sajidhasanapon/4-bit-SAP-Computer/Block_Diagram/README.txt

The block diagram has been drawn using draw.io

The diagram can be edited using the .xml file.

1. Go to https://www.draw.io/
2. Select "Open Existing Diagram"
3. Browse and upload the .xml file
