sajidhasanapon/4-bit-SAP-Computer/Report/Final_Report/DOCX/Cover.docx

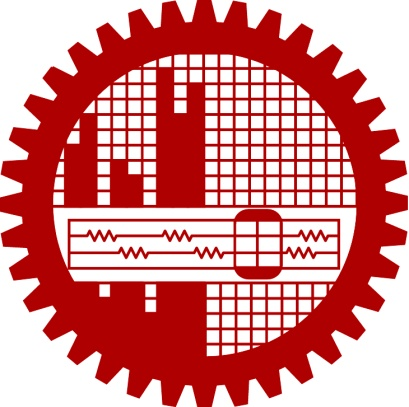
[picture p2: figure]

BANGLADESH UNIVERSITY OF ENGINEERING & TECHNOLOGY

CSE 404

DIGITAL SYSTEM DESIGN SESSIONAL

4-BIT SIMPLE AS POSSIBLE (SAP) COMPUTER

Submitted By: 1305006 1305020 1305026 1305056 1305058 | Section: B1 Group: 03
