sajidhasanapon/4-bit-SAP-Computer/Report/Timing_Diagrams/timing_out.xlsx

 |  | T5
CLK | `
EA_BAR
LO_BAR
RESET
