sajidhasanapon/4-bit-SAP-Computer/Report/Timing_Diagrams/timing_ret.xlsx

 |  | T5 | T6 | T7 | T8
CLK | `
LM_BAR
EM_BAR
R_BAR
EDB_BAR
ES_BAR
LDR_BAR
LP
CP
IS
RESET
