sajidhasanapon/4-bit-SAP-Computer/Report/Schematics/mar.pdf

# M7 GND

U66:A

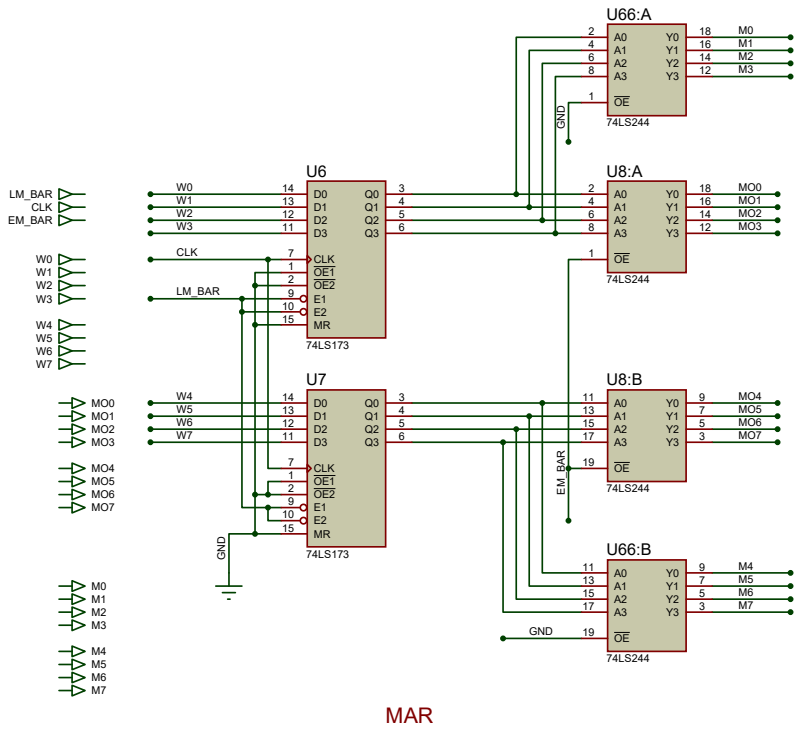
[picture p3: page 1]
