sajidhasanapon/4-bit-SAP-Computer/Report/Schematics/pc.pdf

U45:A

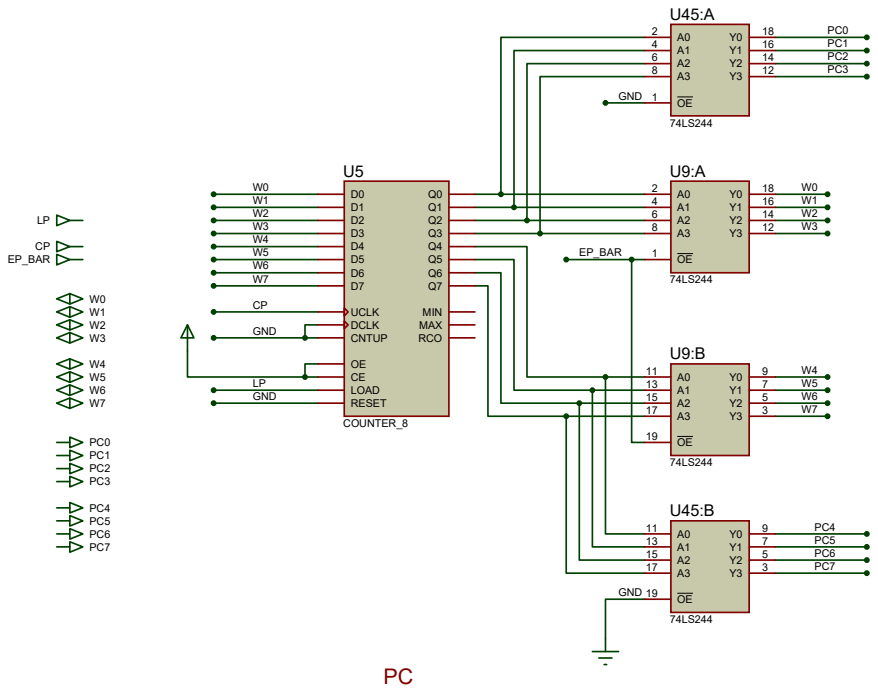
[picture p4: page 1]

GND | 1

A1 13
A2 15
A3 17
