sajidhasanapon/4-bit-SAP-Computer/Report/Schematics/sp.pdf

U25:A

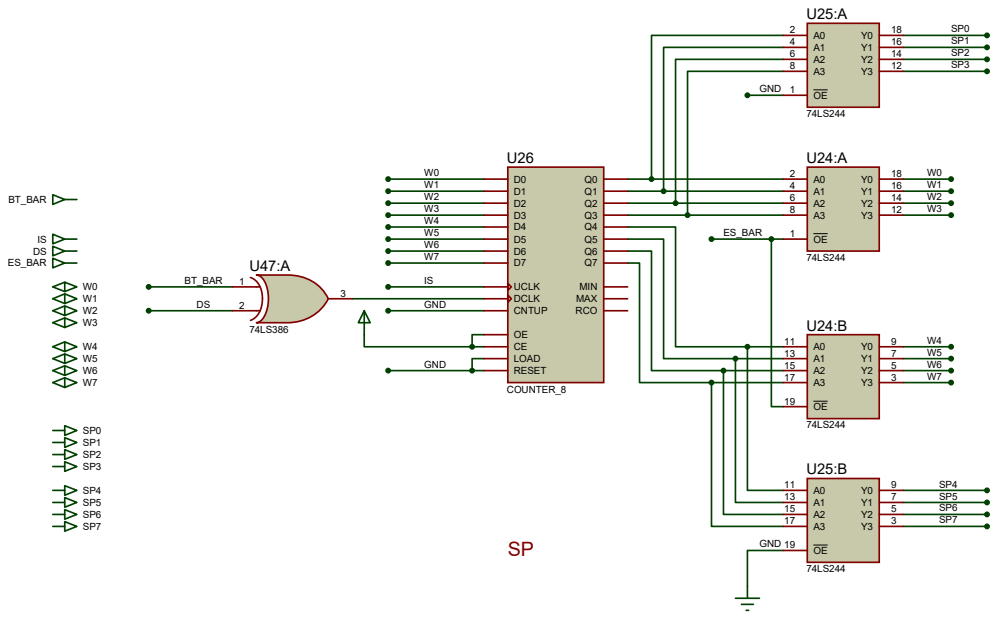
[picture p5: page 1]

GND | 1
