sajidhasanapon/4-bit-SAP-Computer/Report/Schematics/acc.pdf

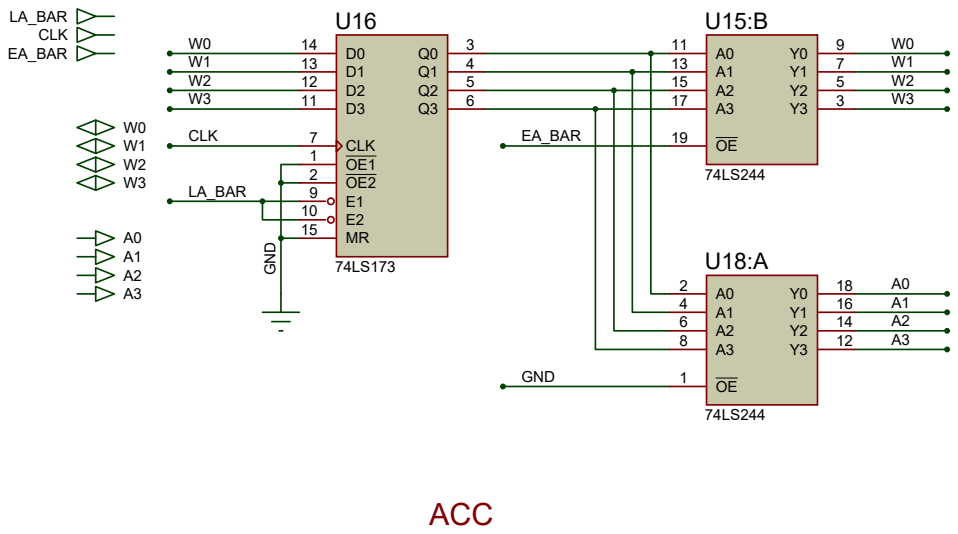
[picture p6: page 1]

4 | A1 13
5 | | A2 15
6 | | | A3 17

9 | E2 10 MR 15
