sajidhasanapon/4-bit-SAP-Computer/Report/Schematics/alu.pdf

U29:A

U35:B

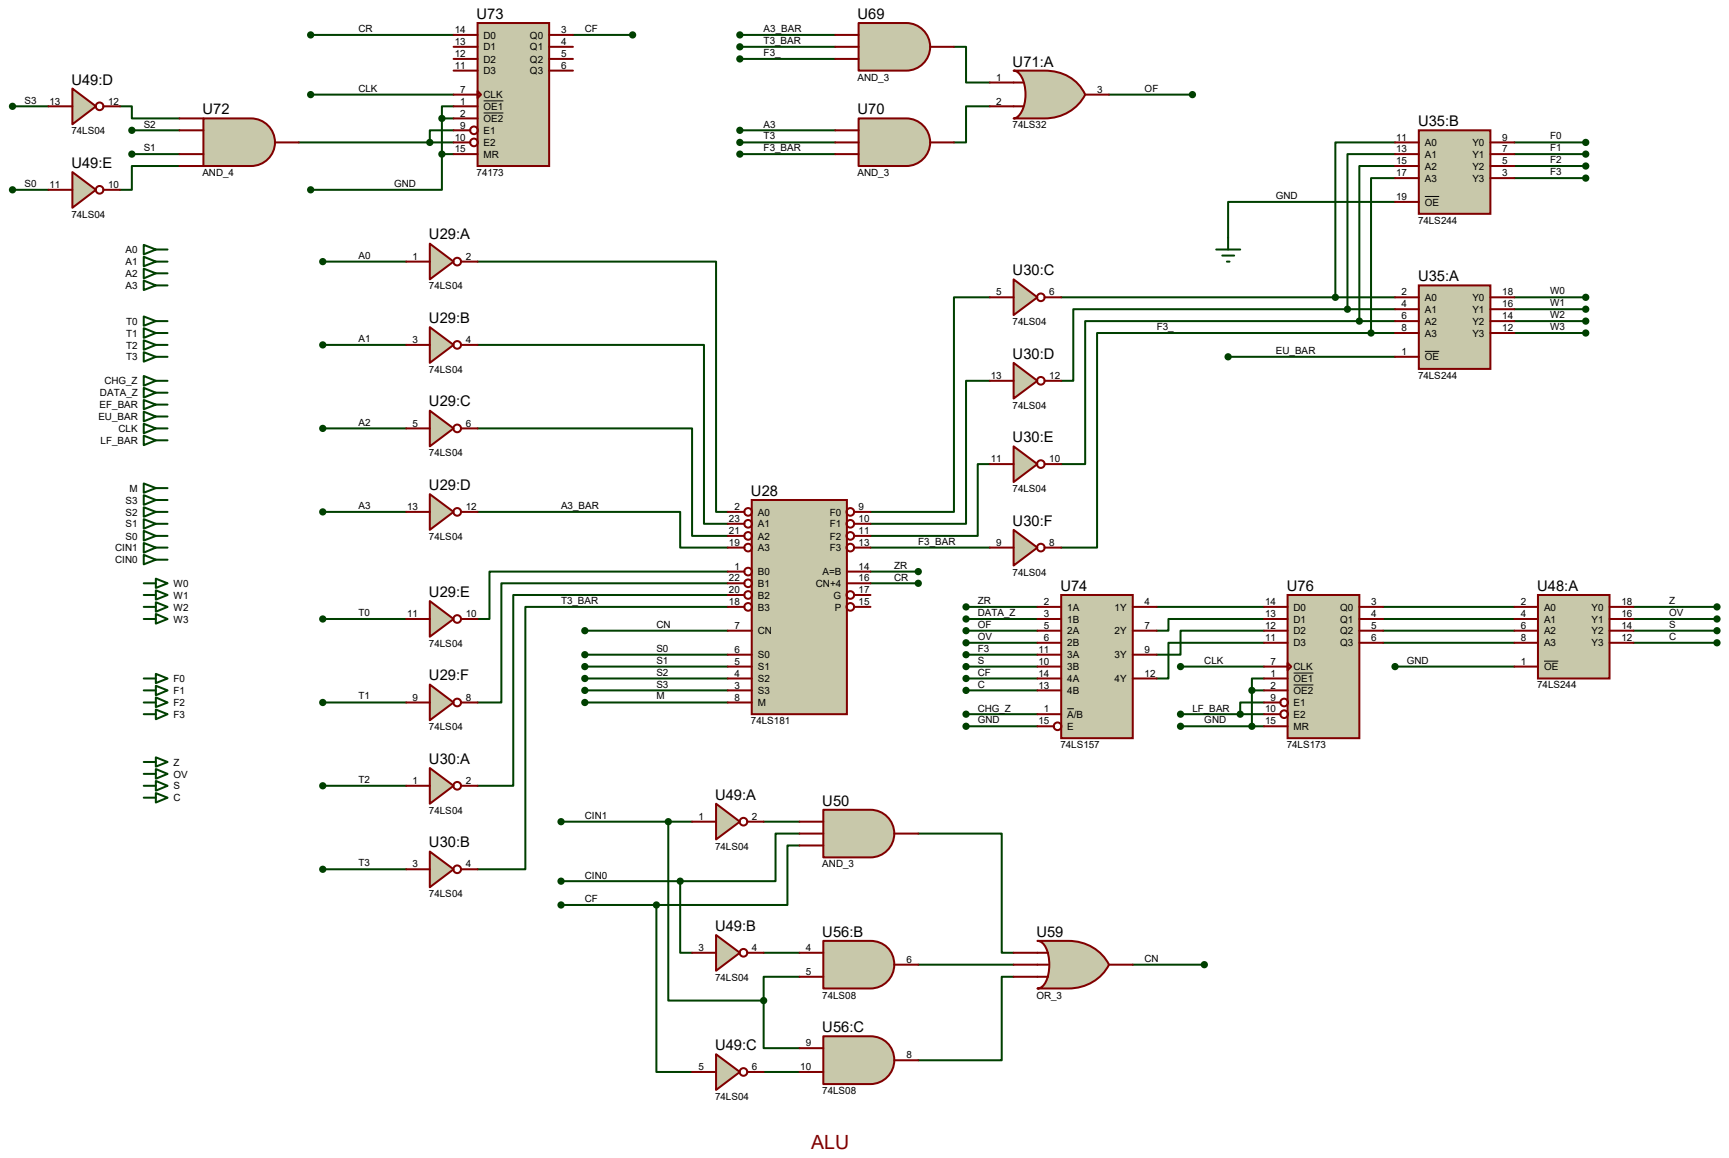
[picture p7: page 1]

9 | E2 10

EU_BAR | 1

CLK
