sajidhasanapon/4-bit-SAP-Computer/Report/Schematics/controller.pdf

U38

U40

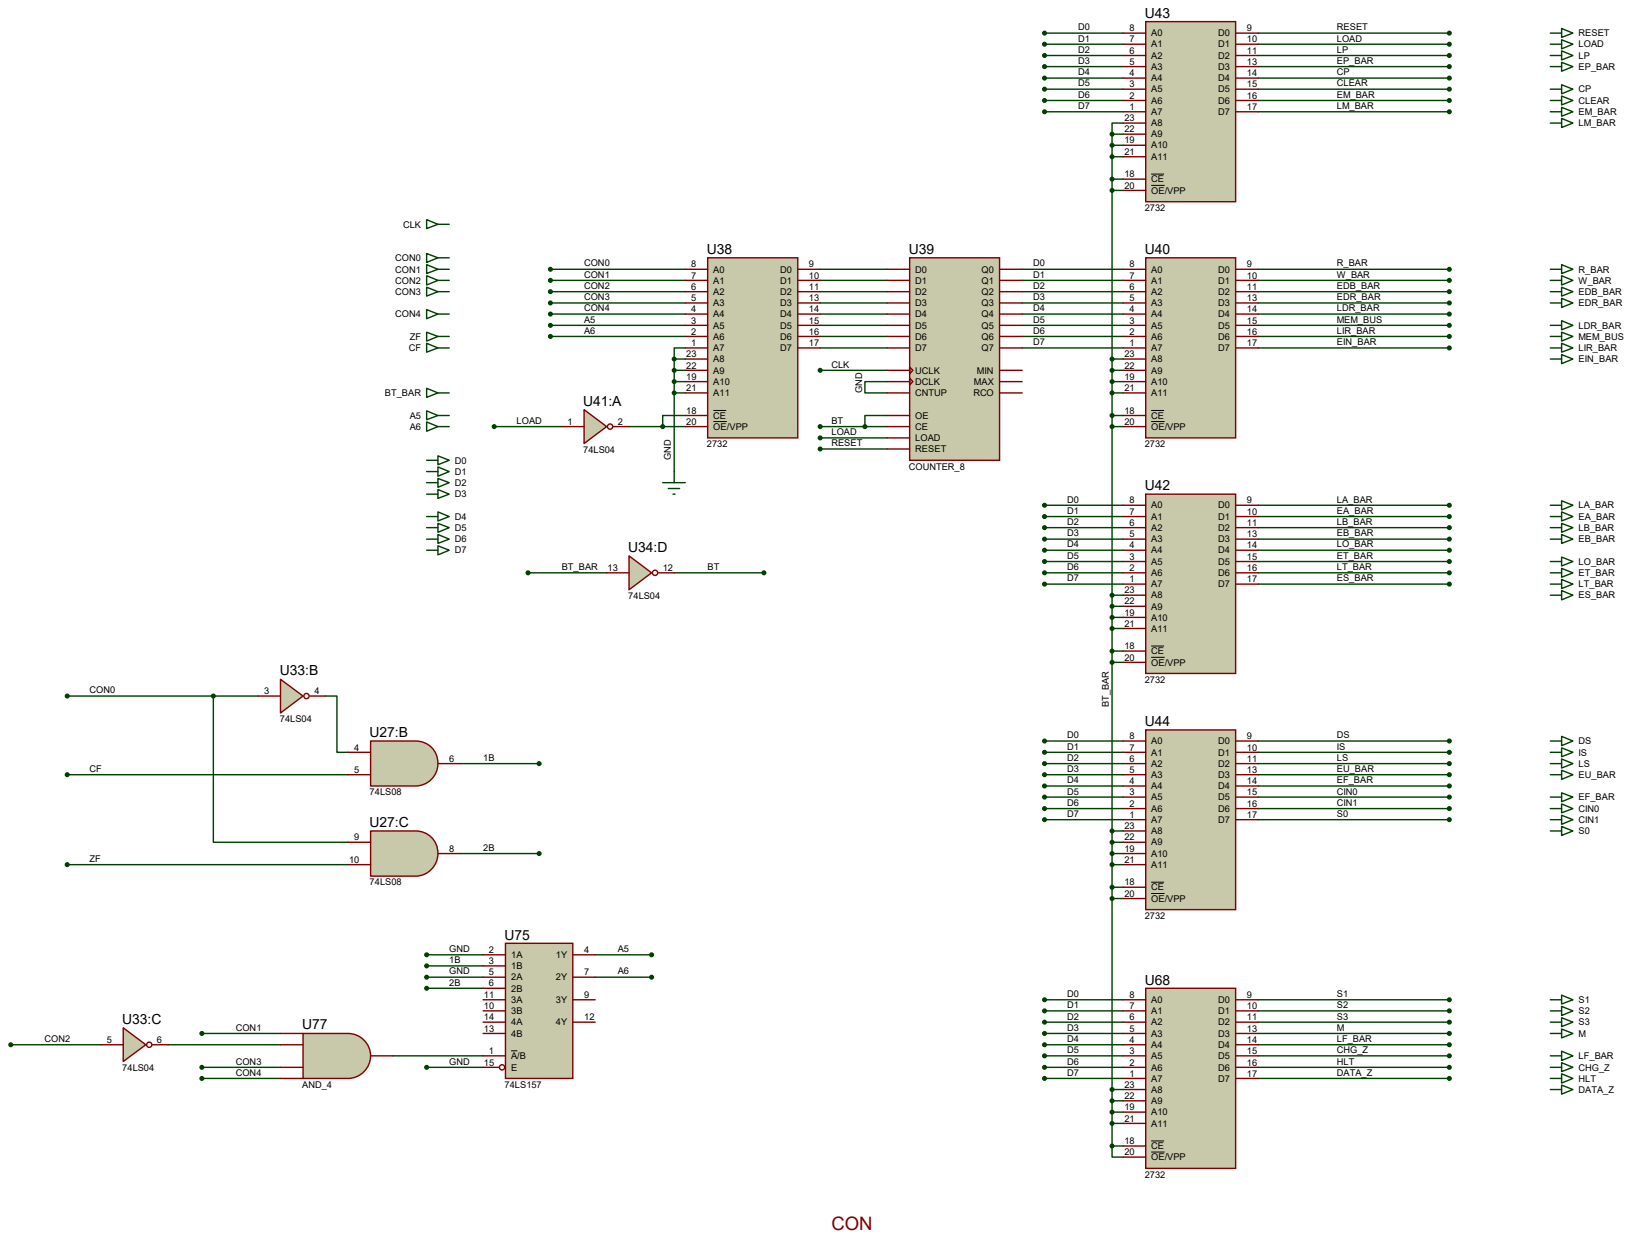
[picture p8: page 1]
