sajidhasanapon/4-bit-SAP-Computer/Report/Schematics/ir.pdf

U17

U4:A

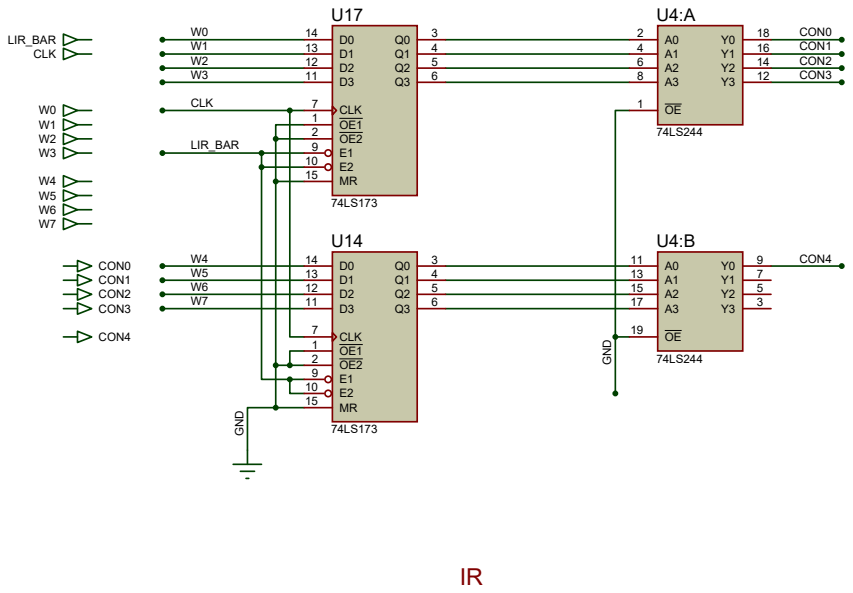
[picture p9: page 1]
