sajidhasanapon/4-bit-SAP-Computer/Report/Schematics/main.pdf

# ES_BAR M

## MAR

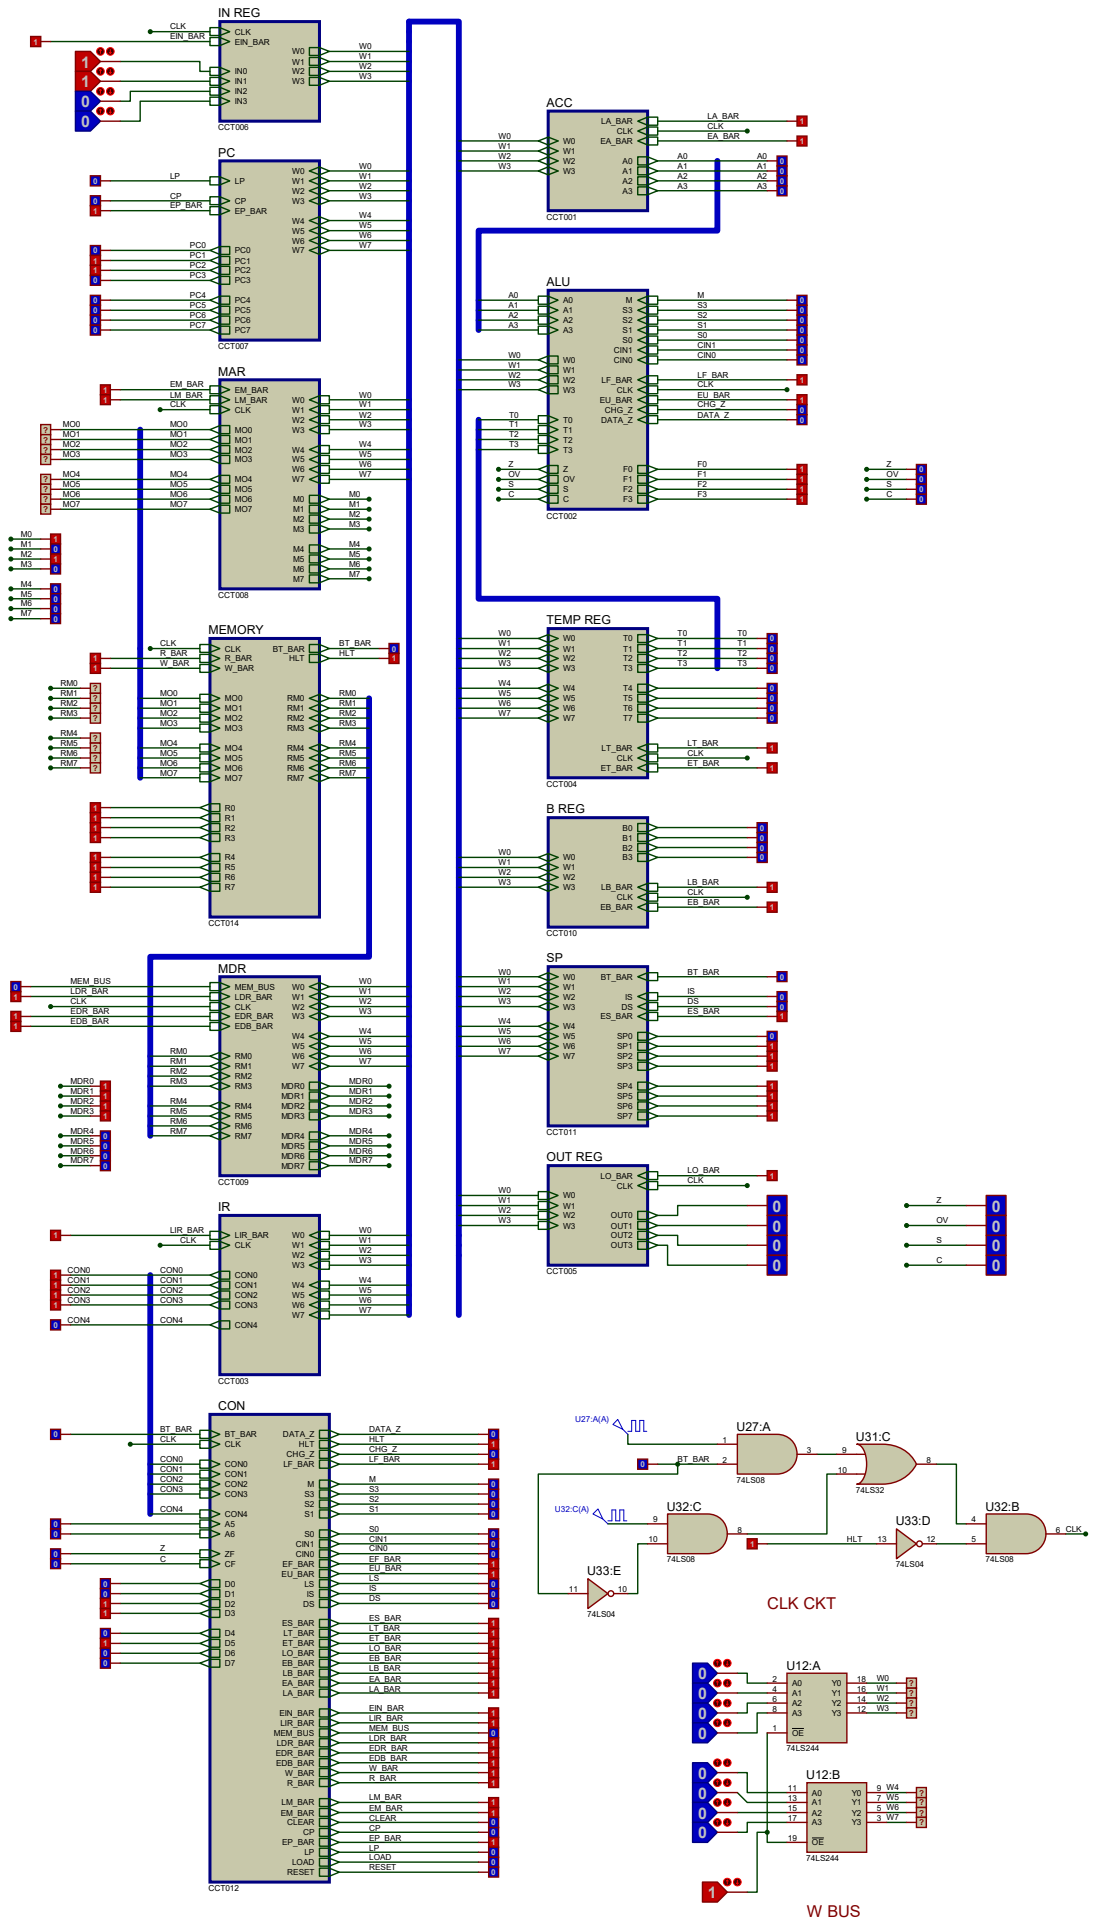
[picture p10: page 1]
