sajidhasanapon/4-bit-SAP-Computer/Report/Schematics/mdr.pdf

U2

U10:A

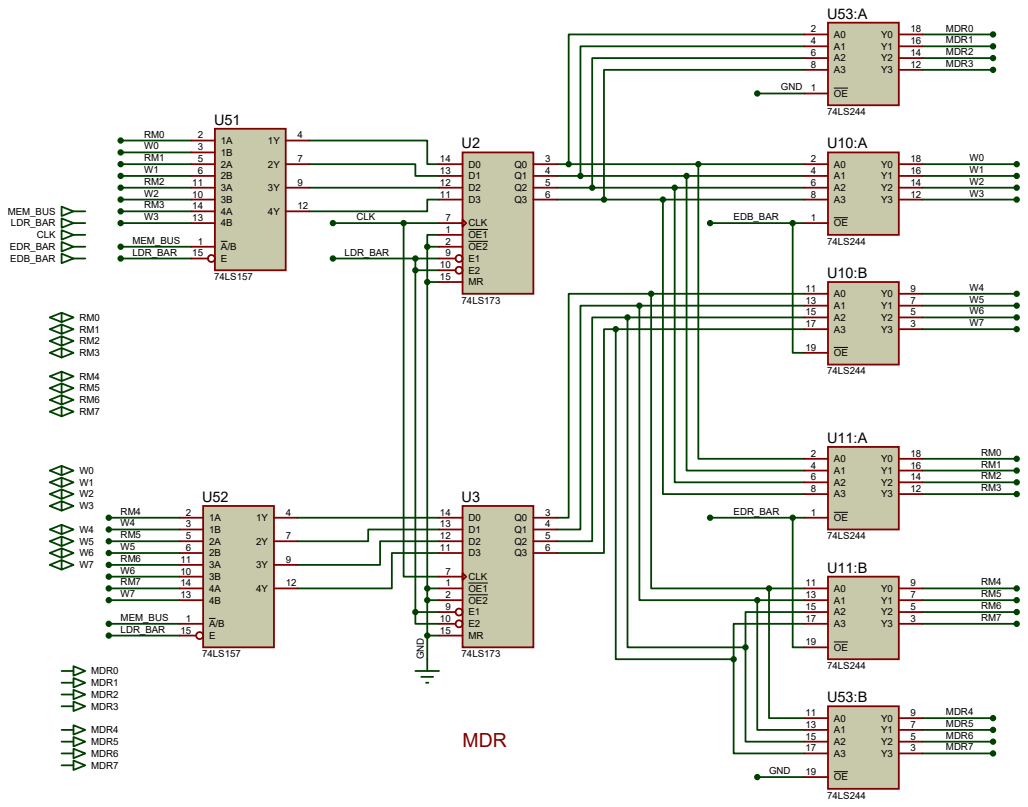
[picture p11: page 1]
