sajidhasanapon/4-bit-SAP-Computer/Report/Schematics/memory.pdf

U54

U55

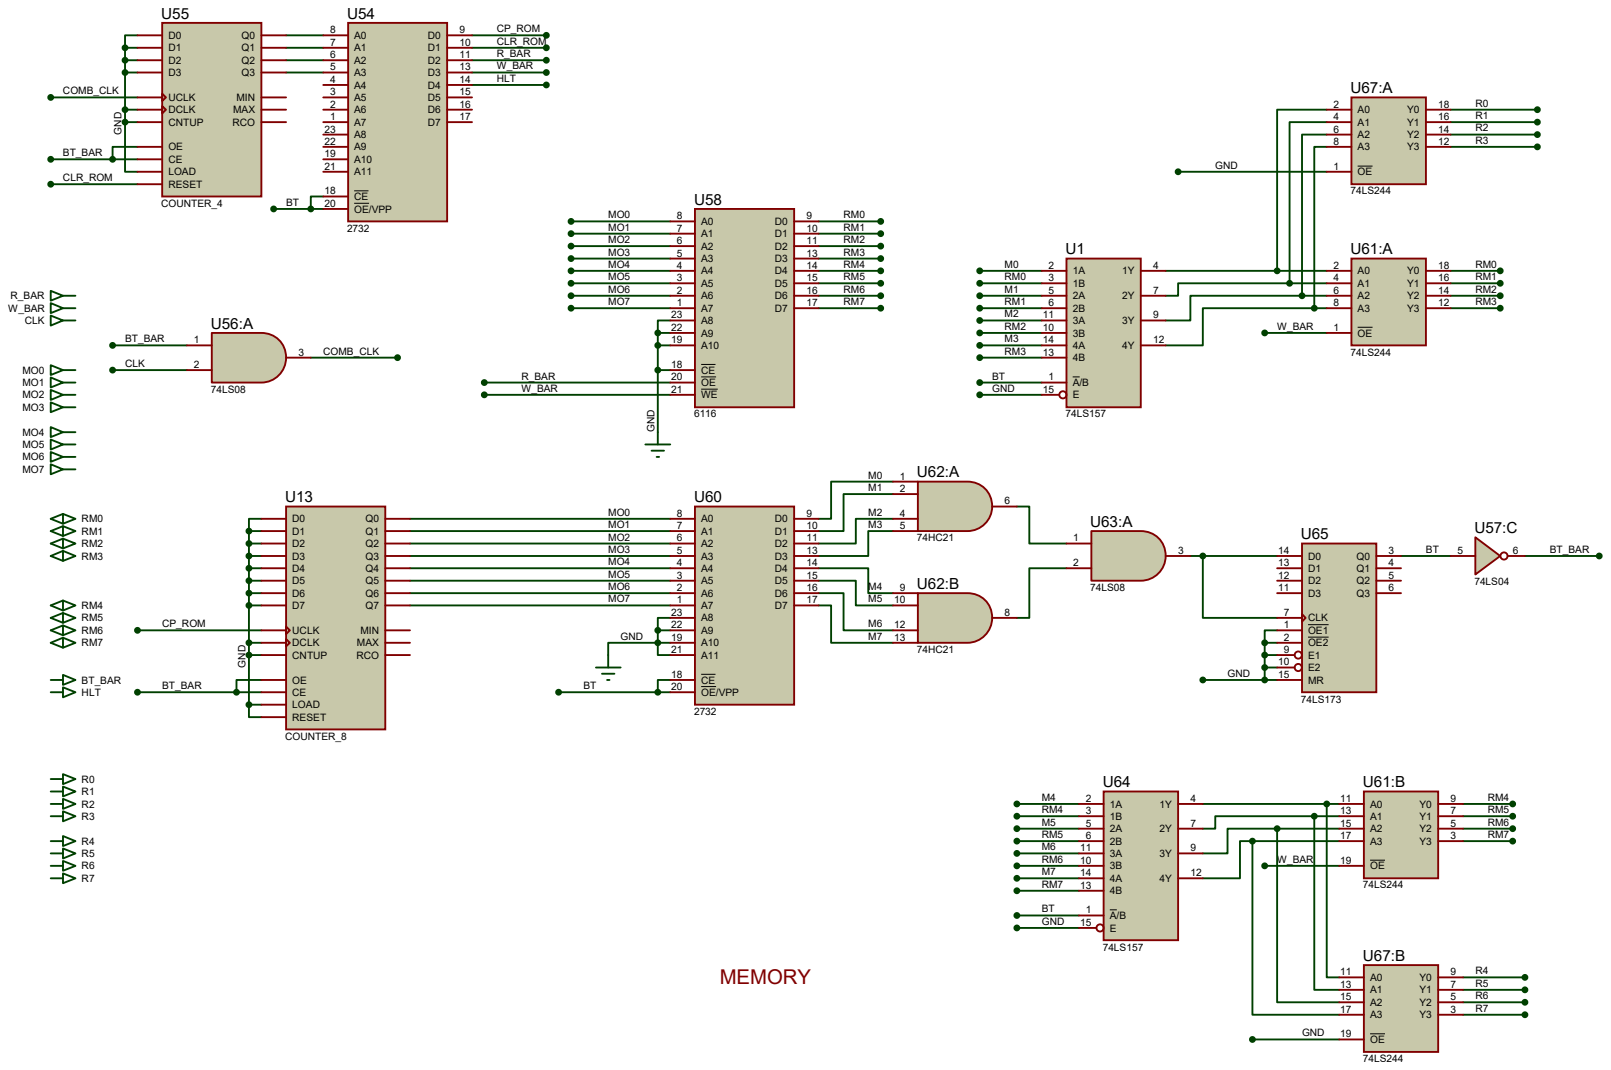
[picture p12: page 1]
