sajidhasanapon/4-bit-SAP-Computer/(list of files, drawings)

Other design files:
Proteus_Simulation/ProteusProject.pdsprj
