sajidhasanapon/4-bit-SAP-Computer/Our_Instructions.txt

LDA address;
STA address;
MOV Acc, B;
MOV B, Acc;
MOV Acc, immediate;
IN;
OUT;
ADD B;
ADC B;
SUB B;
SBB B;
ADC immediate;
SBB immediate;
CMP B;
XCHG;
JC address;
JE address;
PUSH;
POP;
CALL address;
RET;
JMP;
HLT;
NOP;
STZ;
CLZ;
AND immediate;
OR [address];
