sajidhasanapon/4-bit-SAP-Computer/(commit log)

2018-01-28 Final Submission Added report Added schematics Reorganized the repository
    [Code.xlsx, ProteusProject.pdsprj, sap.xlsx]
2018-01-28 Final Submission Added project files for block diagram Added project files for timing diagrams Reorganized the repository
    [ProteusProject.pdsprj, timing_call.xlsx, timing_out.xlsx, timing_ret.xlsx]
